JorgeRojo/mueble-aspiradora/docs/README.md

# Documentación Técnica: Proyecto Mueble Consola Cuadrada Dreame a Cota Cero

Documentación técnica integral para la fabricación, despiece, montaje y automatización del mueble recibidor cuadrado a medida ($540 \times 540\text{ mm}$) para la estación robot aspirador **Dreame L10s / X40**.

---

## 1. Documentos Técnicos del Proyecto

1. ### [Guía Maestra y Manual de Construcción (`../README.md`)](../README.md)
   * Visión general del mueble con encimera cuadrada de $54 \times 54\text{ cm}$ y altura de $75\text{ cm}$.
   * Lista de materiales comerciales (BOM) y aprovechamiento de los tableros comprados ($60 \times 120\text{ cm}$).
   * Procedimiento de fabricación paso a paso: despiece, cajeado de rodapié, regrueso perimetral a 25 mm, cazoletas de bisagras y acabado en blanco satinado.

2. ### [Especificaciones Técnicas y Constructivas (`especificaciones_tecnicas.md`)](especificaciones_tecnicas.md)
   * **Justificación dimensional de la planta cuadrada ($540 \times 540\text{ mm}$)** a partir de la rampa de la base Dreame y el rodapié de 15 mm.
   * **Arquitectura a Cota Cero**: Apoyo directo sobre el suelo de la vivienda, sin travesaños inferiores ni trasera.
   * **Interior 100% diáfano**: Sin balda intermedia, dejando 157 mm libres sobre la estación Dreame para la extracción vertical de los depósitos de agua.
   * **Sistema de doble puerta batiente**: Dos hojas de $268 \times 723\text{ mm}$ motorizadas con apertura hacia delante.
   * **Automatización y cableado Zigbee**: Conexión de actuadores en paralelo al relé inteligente MHCOZY de 2 canales con enclavamiento (*Interlock*).

3. ### [Planos Técnicos y Esquemas de Cotas (`planos_cotas.md`)](planos_cotas.md)
   * Esquema de cotas en alzado frontal con ambas puertas abiertas.
   * Esquema en planta superior con corte de profundidad, cajeado para rodapié ($18 \times 95\text{ mm}$) y holgura frontal de seguridad ($14\text{ mm}$).
   * Tabla completa de tolerancias y holguras críticas de funcionamiento.

---

## 2. Renders y Planos Fotorrealistas de Referencia

* **Plano Fotorrealista con Cotas Milimétricas**: [`../foto_realista_mueble_cuadrado_cotas.jpg`](../foto_realista_mueble_cuadrado_cotas.jpg)
  * Muestra el mueble acotado milimétricamente ($540 \times 540\text{ mm}$ encimera, $750\text{ mm}$ alto, $268\text{ mm}$ puertas, $490\text{ mm}$ interior, $423\text{ mm}$ base, $157\text{ mm}$ espacio libre superior y actuadores 12V con carrera de 150 mm).
* **Fotografía Realista Principal (Doble Puerta Abierta)**: [`../foto_realista_mueble_cuadrado_dos_puertas.jpg`](../foto_realista_mueble_cuadrado_dos_puertas.jpg)
  * Muestra la consola cuadrada lacada en blanco satinado, las dos puertas abiertas hacia delante a cota cero, la estación Dreame interior y el robot saliendo por el centro sobre el parqué de espiga.
