JorgeRojo/mueble-aspiradora/foto_realista_mueble_cuadrado_cotas.jpg

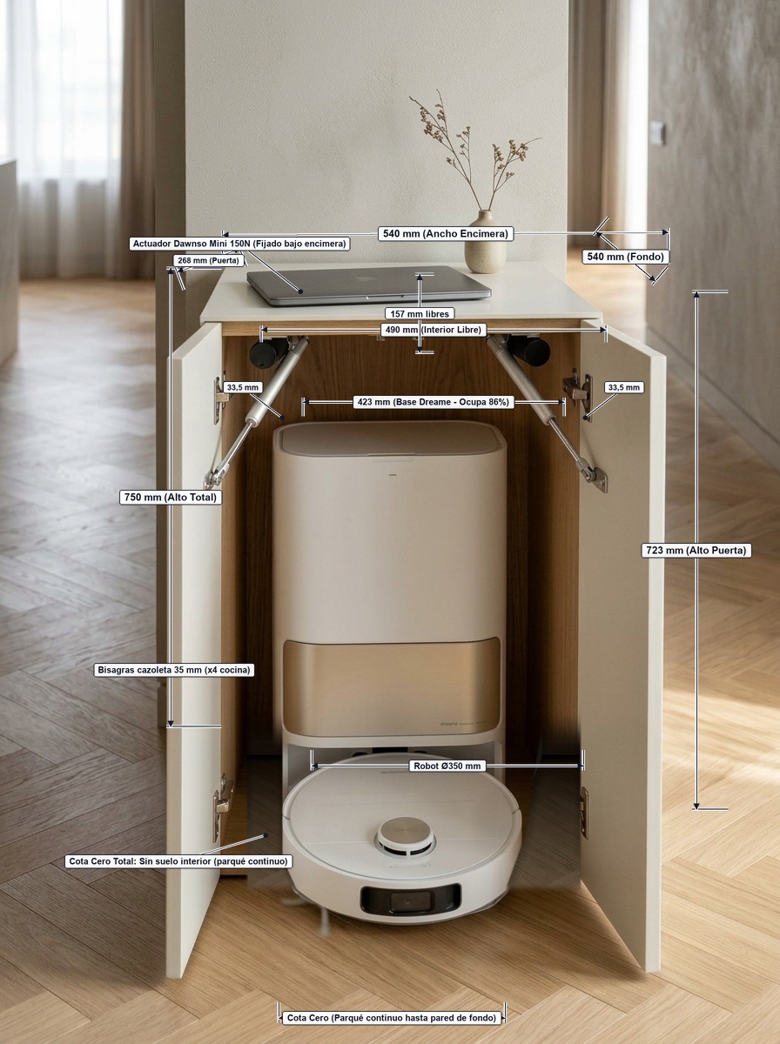
foto_realista_mueble_cuadrado_cotas.jpg
