JorgeRojo/mueble-aspiradora/planos/Vista_3D_Mecanismo_Abierto_Detalle.png

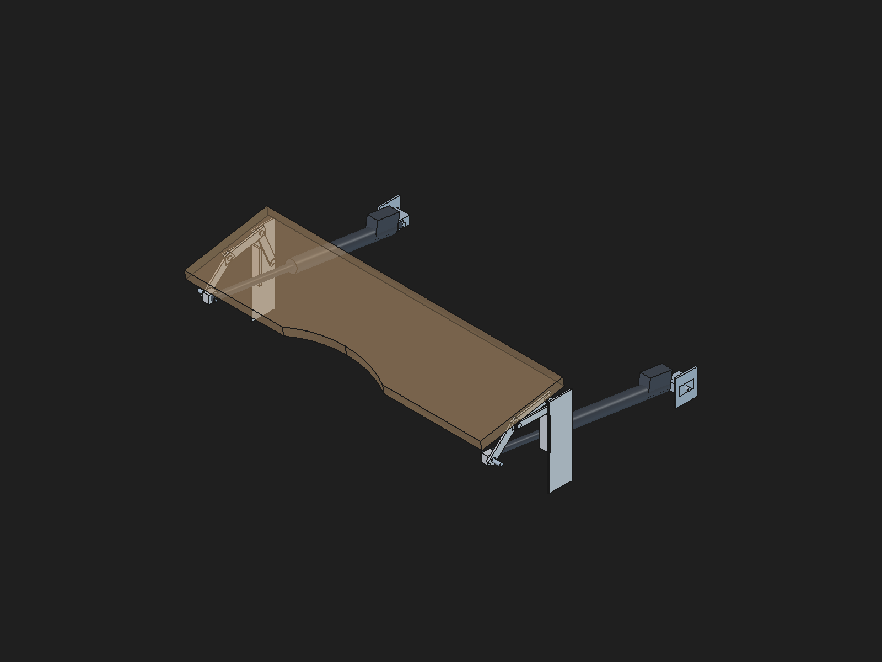
planos/Vista_3D_Mecanismo_Abierto_Detalle.png
