JorgeRojo/mueble-aspiradora/planos/Vista_3D_Perfil_Mecanismo_Abierto.png

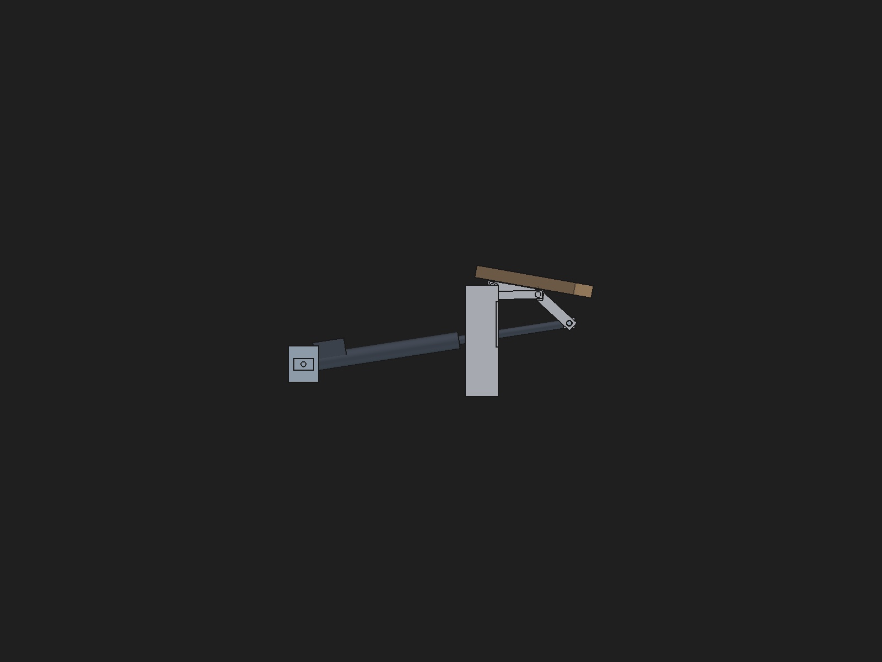
planos/Vista_3D_Perfil_Mecanismo_Abierto.png
