JorgeRojo/mueble-aspiradora/planos/Vista_3D_Trasera_Nervio_Superior.png

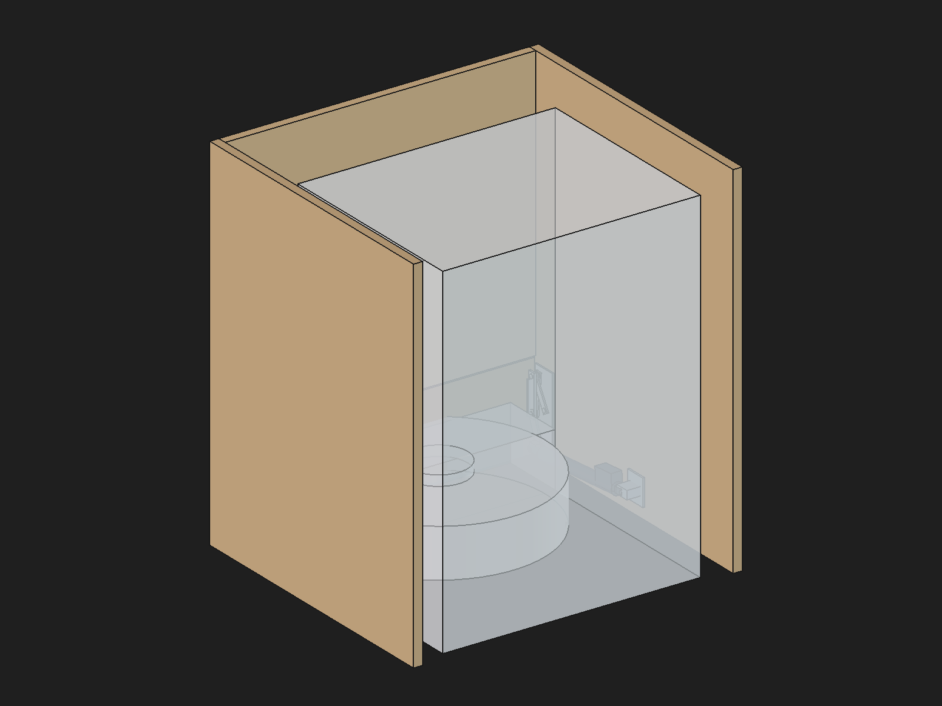
planos/Vista_3D_Trasera_Nervio_Superior.png
