JorgeRojo/mueble-aspiradora/Mueble_Aspiradora_Cota_Cero.FCStd

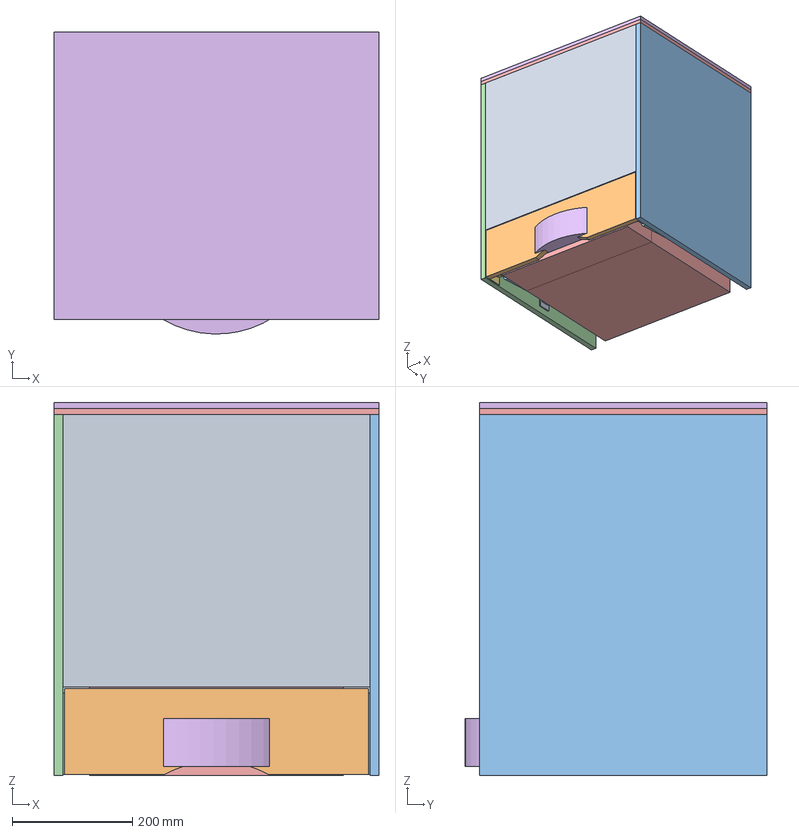
[picture p10: CAD file, 2026-11-04]
Mueble_Aspiradora_Cota_Cero.FCStd
540.0 x 501.9 x 620.0 mm
[P03] Cubierta Frontal Fija (510x453x15mm)
[P04] Porton Abatible 80deg (506x143x15mm)
[P02] Costado Derecho (478x600x15mm)
[P01] Costado Izquierdo (478x600x15mm)
Estacion Dreame (423x480x568mm)
Robot Dreame (Ø350x97mm)
[H01] Bisagra Garosa 80deg SIN Muelle Izq
[H01] Bisagra Garosa 80deg SIN Muelle Der
[H03] Soportes Actuador Lineal Izq
[H03] Soportes Actuador Lineal Der
[H02] Actuador Lineal Dawnso 215/325mm Izq
[H02] Actuador Lineal Dawnso 215/325mm Der
[P06] Lamina Superior Base (540x478x10mm)
[P07] Lamina Superior Tapa (540x478x10mm)
[P05] Nervio Trasero Superior (510x35x15mm)
