JorgeRojo/mueble-aspiradora/planos/Mecanismo_Metalico_Bisagras_y_Actuadores.step

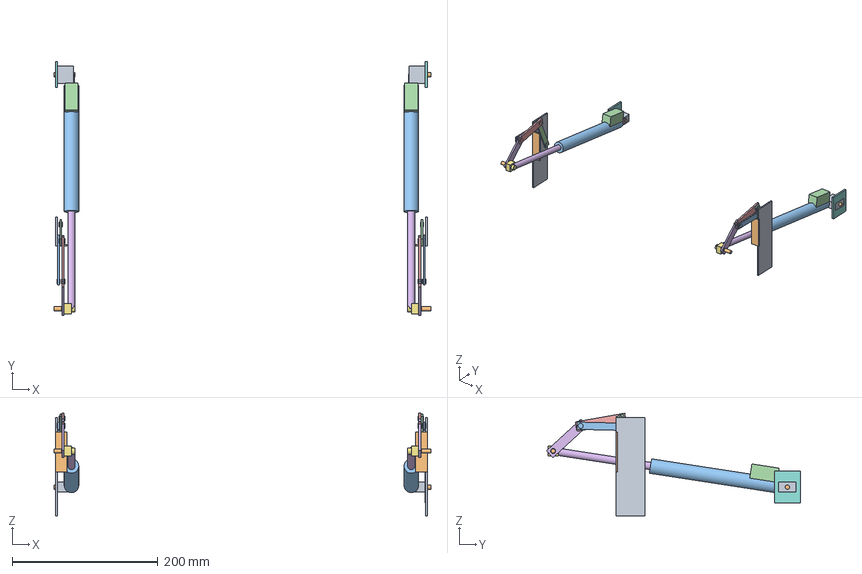
[picture p11: CAD file, 2026-11-01]
planos/Mecanismo_Metalico_Bisagras_y_Actuadores.step
517.0 x 348.4 x 140.7 mm
