JorgeRojo/mueble-aspiradora/(list of files, cad)

Other CAD files:
Mecanismo_Metalico_Bisagras_y_Actuadores.FCStd
Modulo_01_Porton_Abierto_80deg.FCStd
