JorgeRojo/mueble-aspiradora/planos/Planos_Corte_Madera_Diseño_Final_A4.pdf

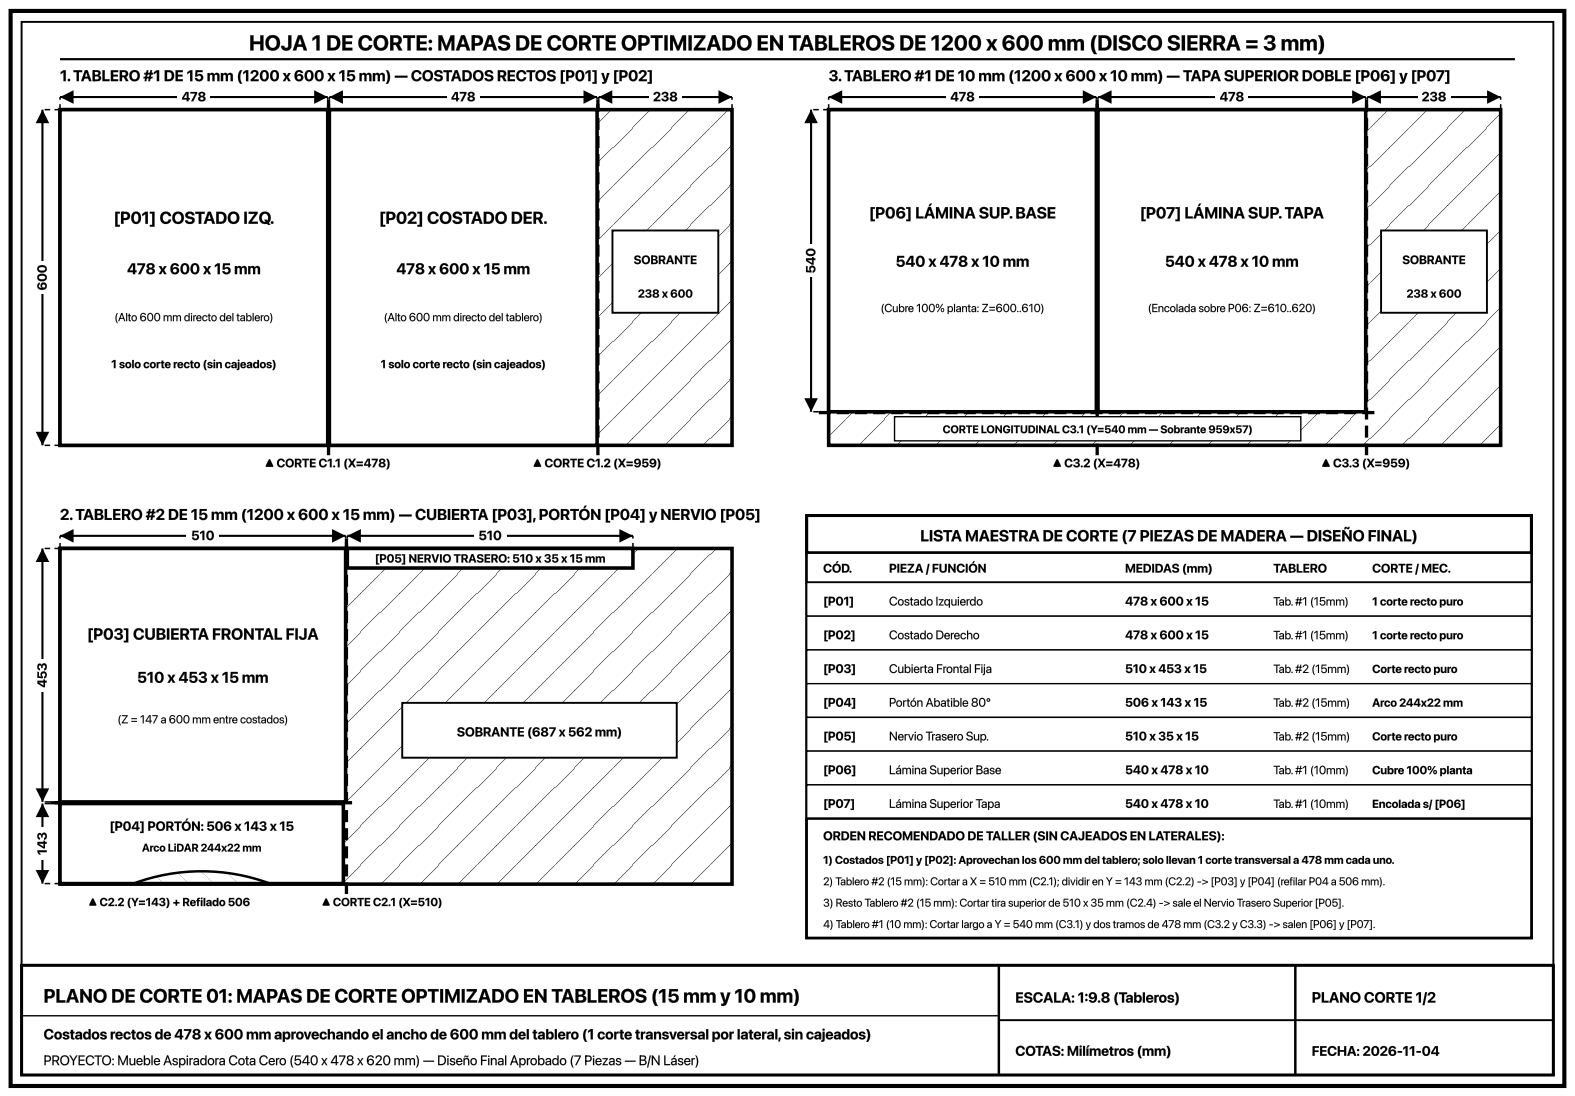
[picture p13: page 1]

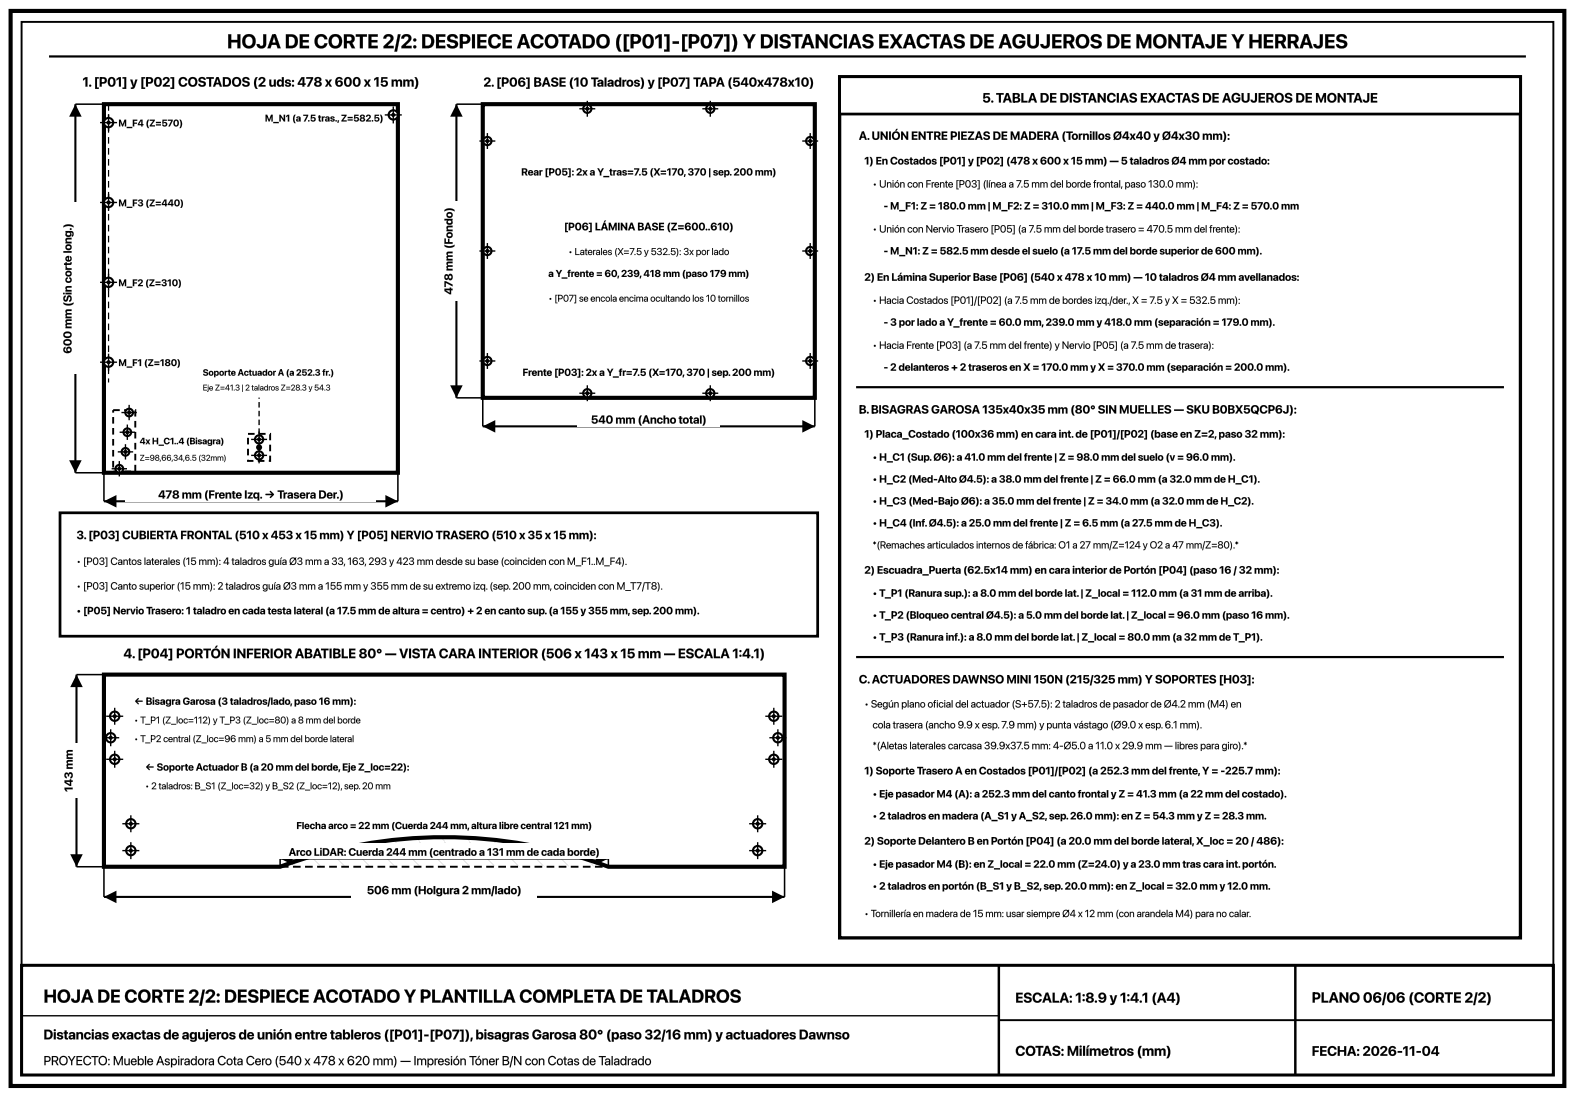
[picture p14: page 2]
