JorgeRojo/mueble-aspiradora/ssss.pdf

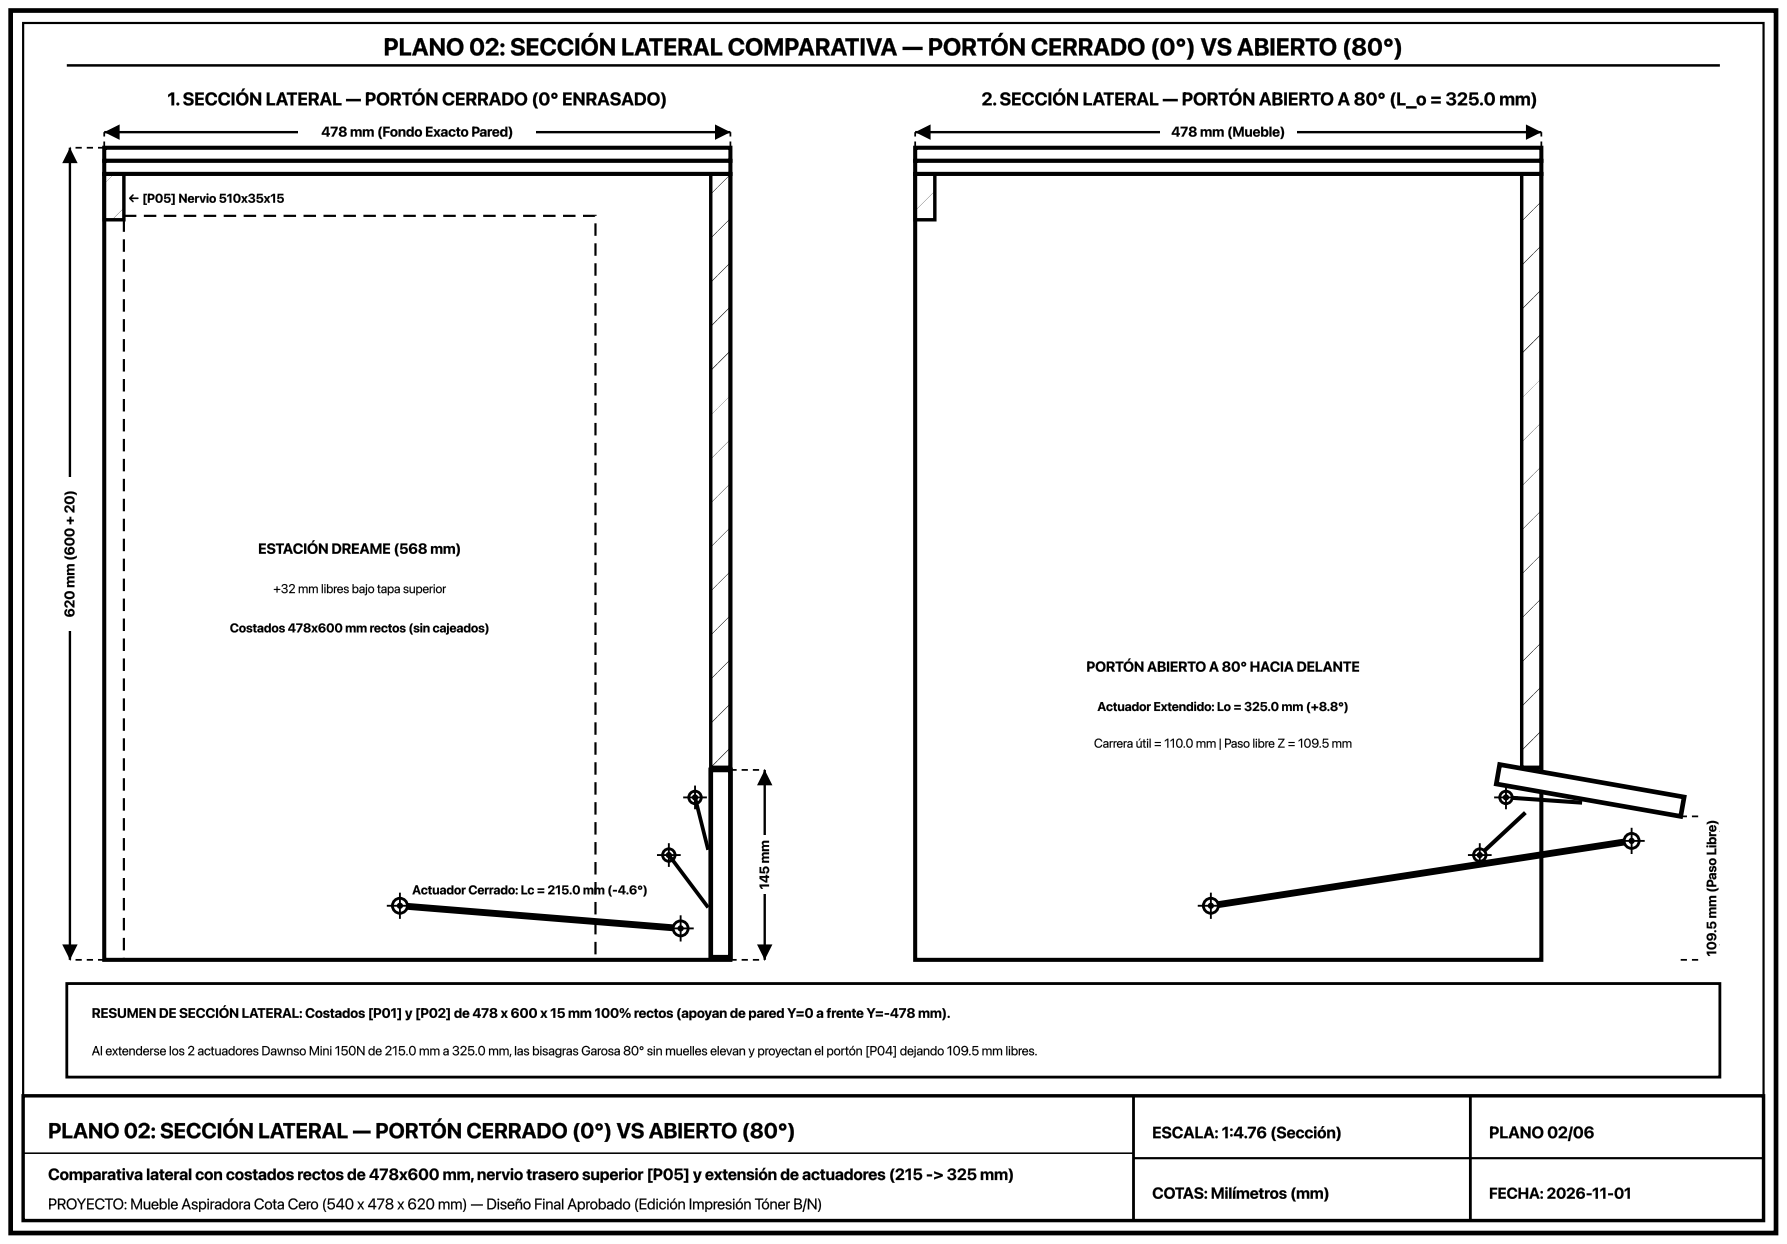
[picture p15: page 1]
