JorgeRojo/mueble-aspiradora/planos/Plano_01_Alzado_y_Planta_A4.pdf

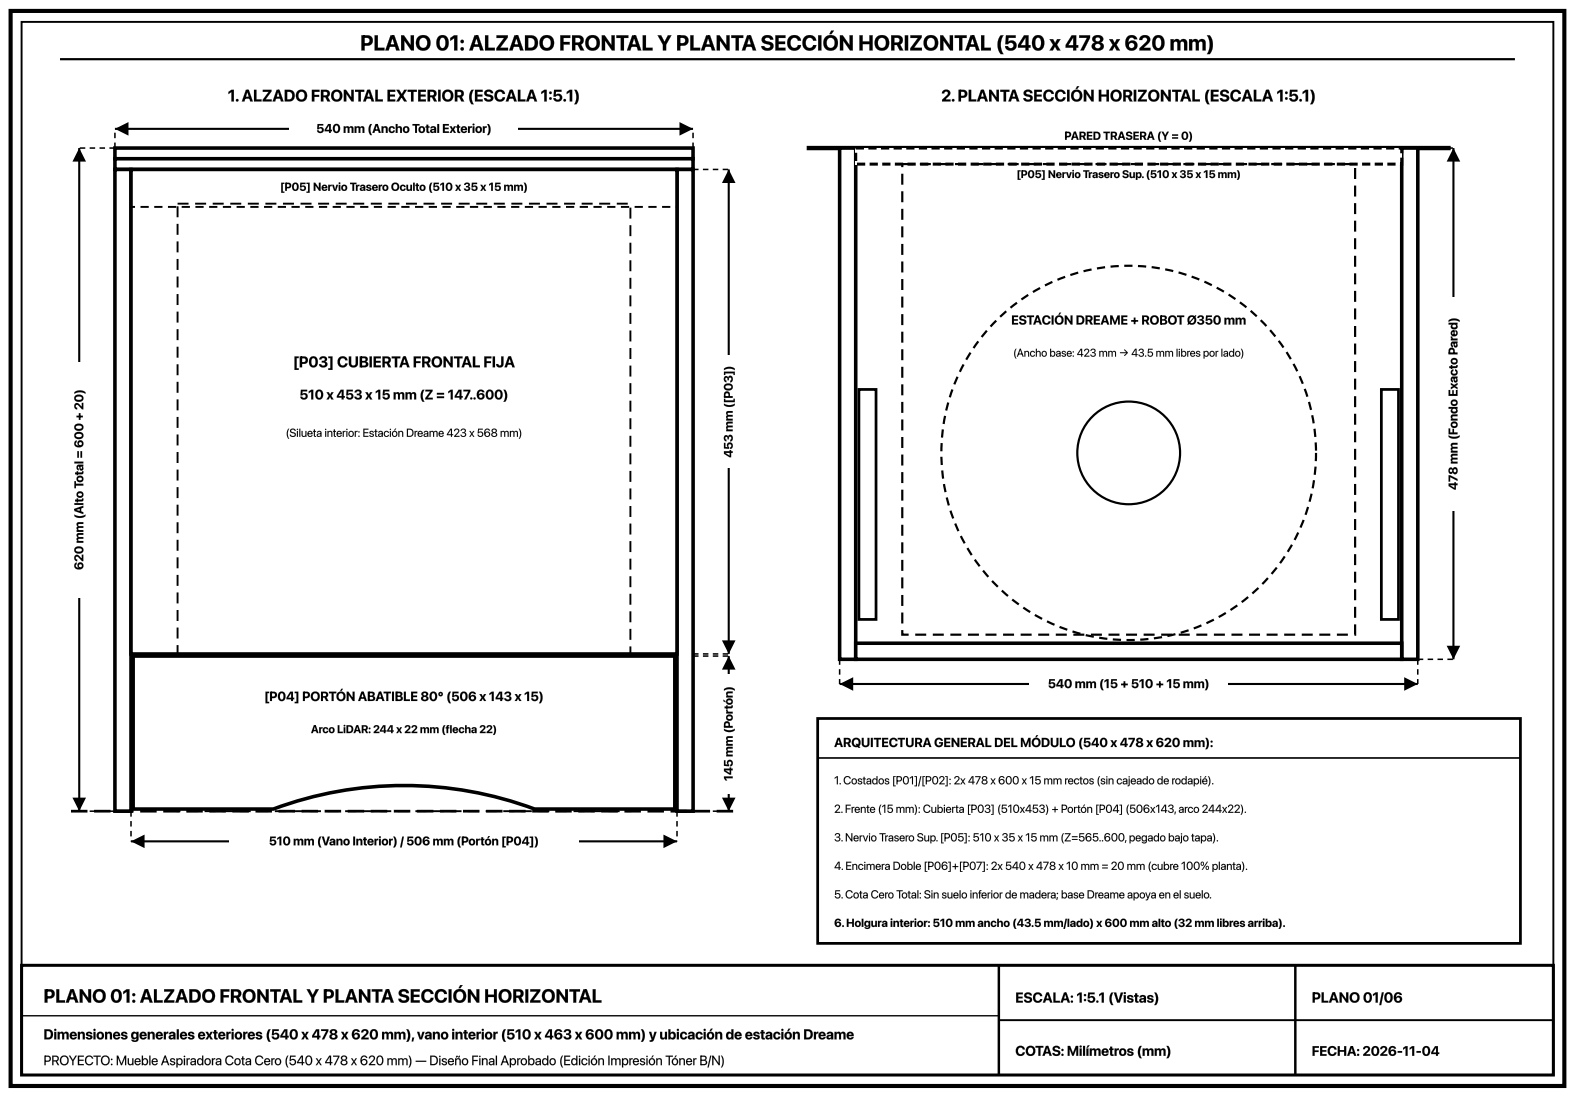
[picture p16: page 1]
