JorgeRojo/mueble-aspiradora/planos/Plano_02_Perfil_e_Isometrica_A4.pdf

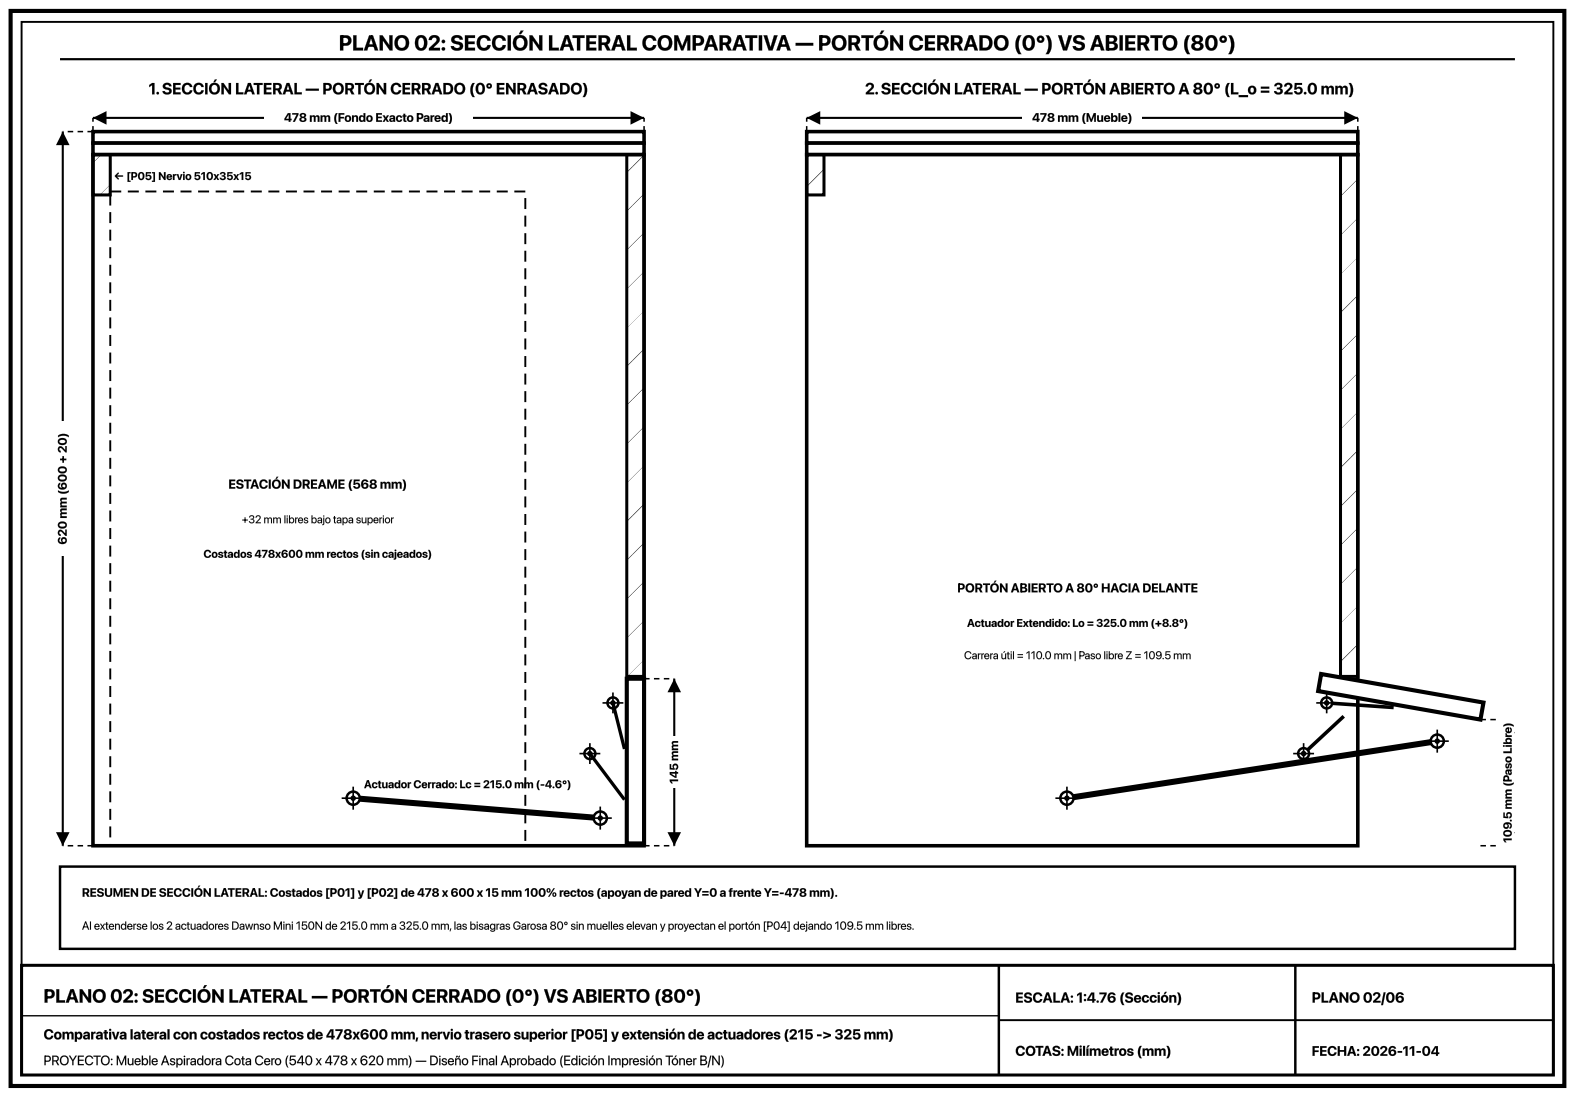
[picture p17: page 1]
