JorgeRojo/mueble-aspiradora/planos/Plano_03_Despiece_Carpinteria_A4.pdf

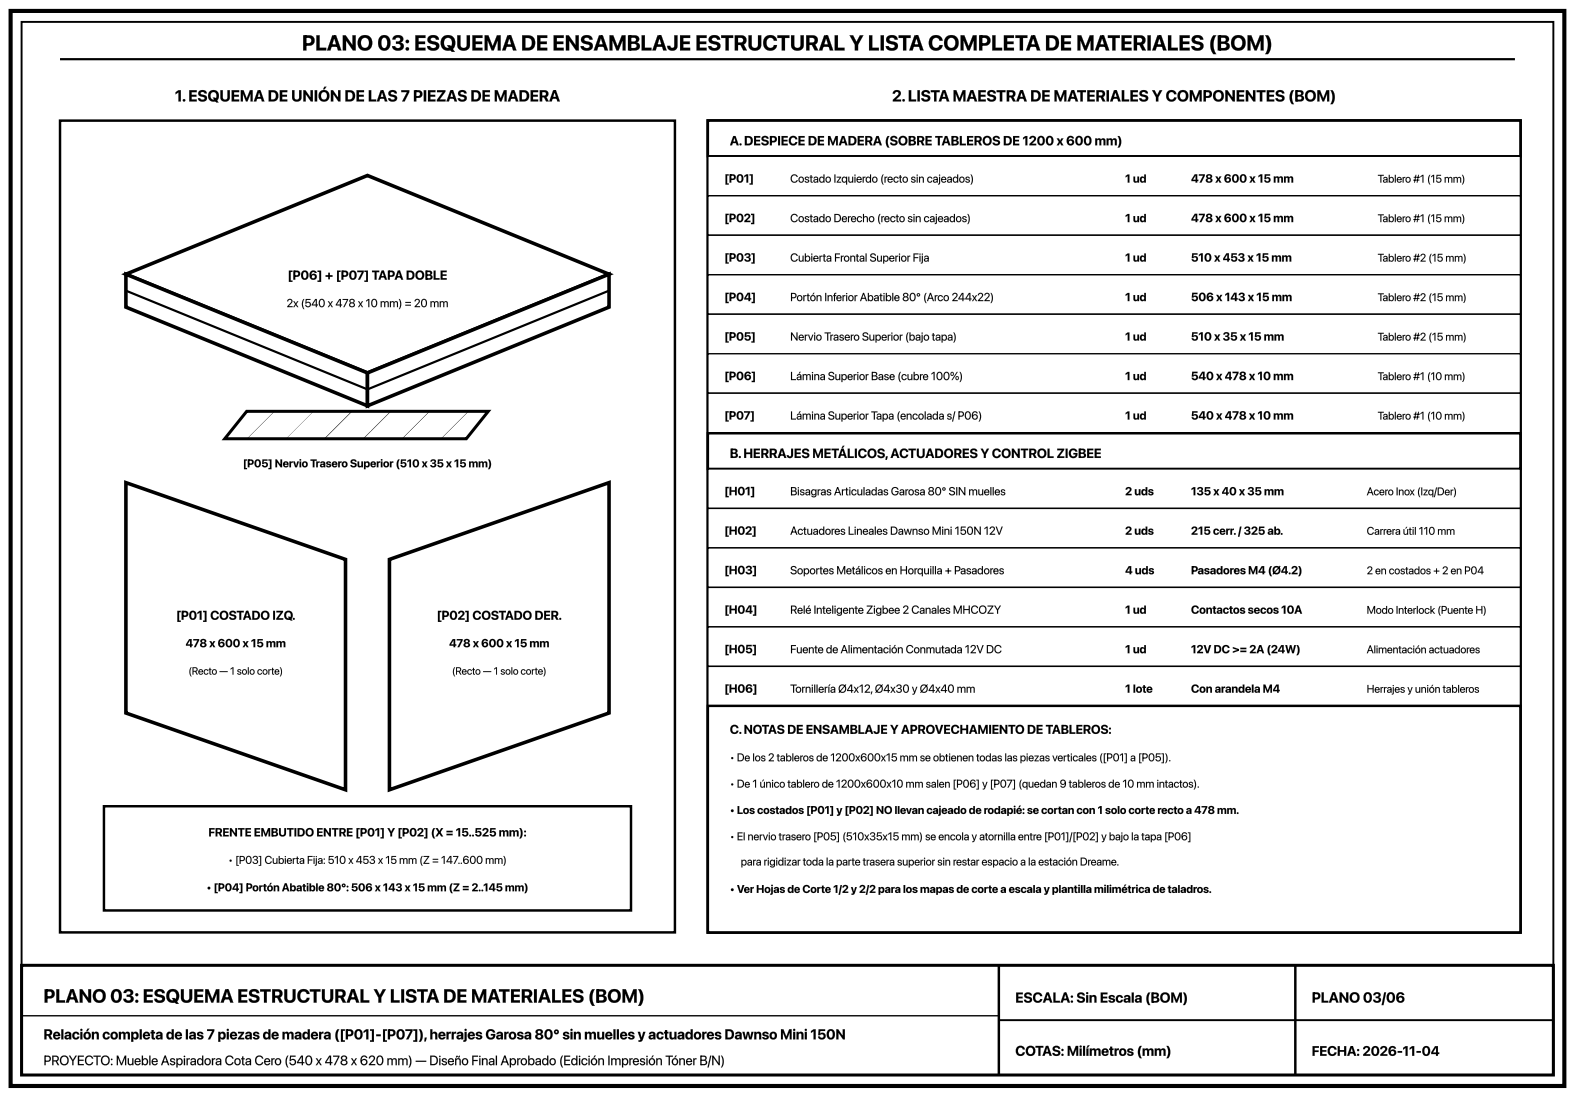
[picture p18: page 1]
