JorgeRojo/mueble-aspiradora/planos/Plano_04_Cinematica_Bisagras_80deg_y_Actuadores_A4.pdf

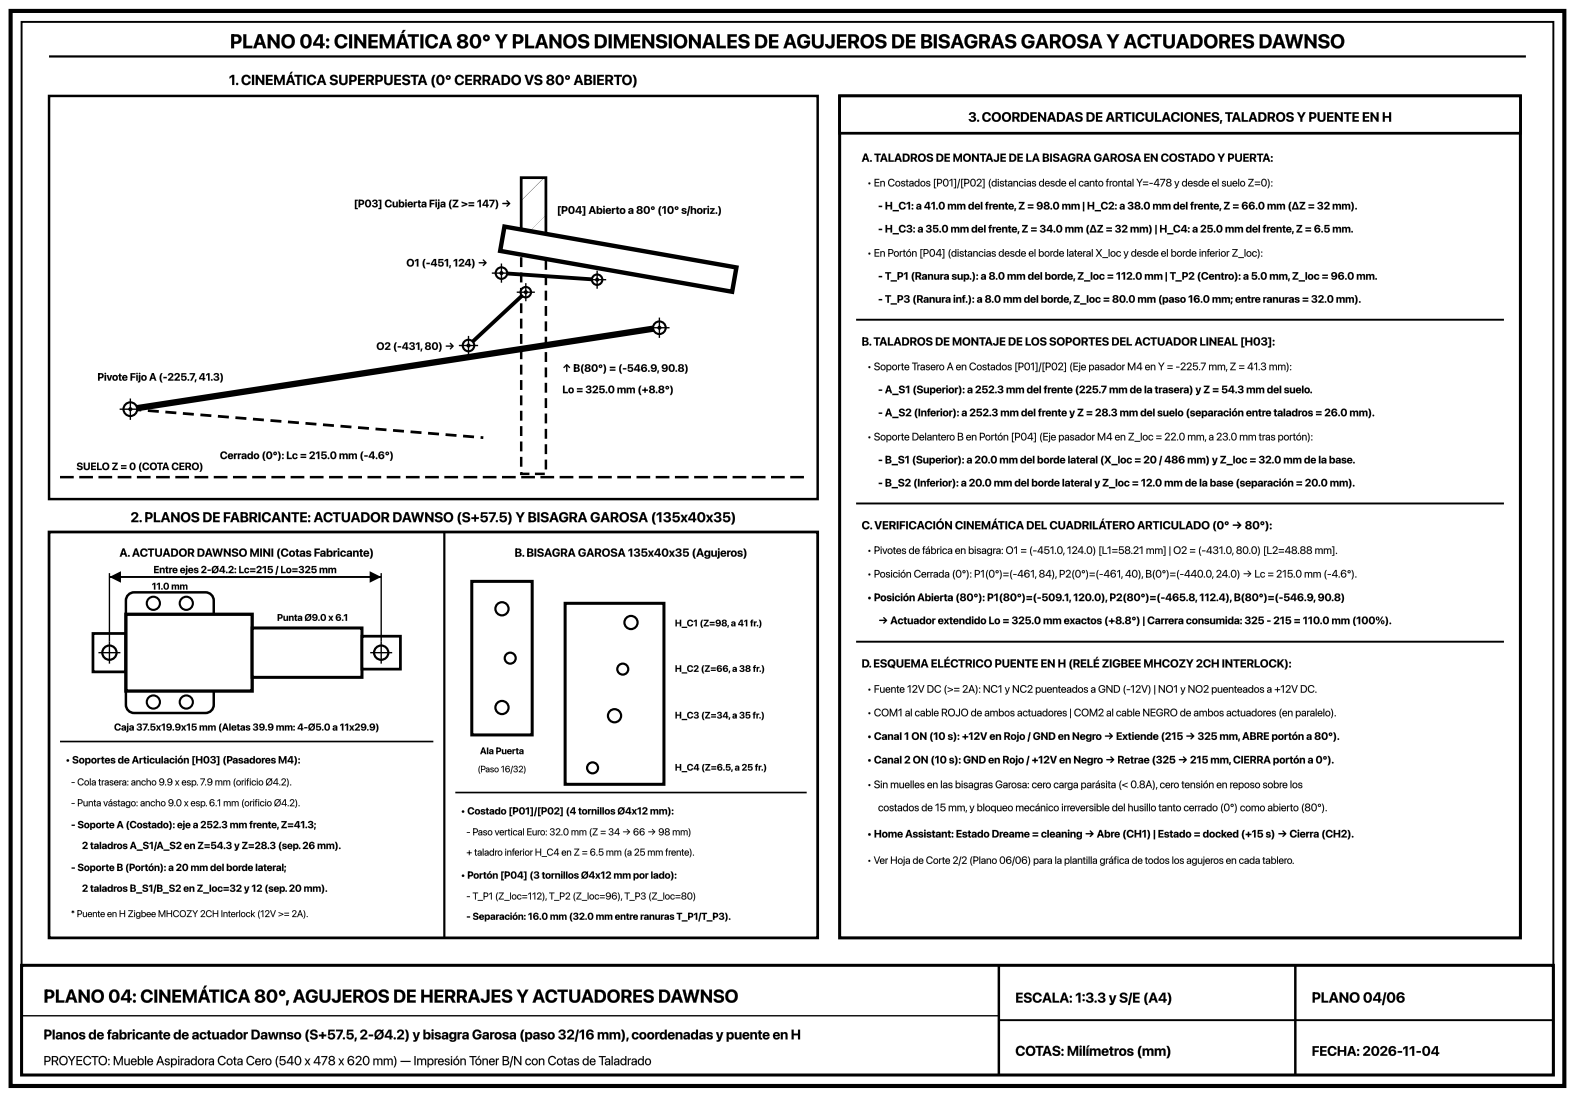
[picture p19: page 1]
