JorgeRojo/mueble-aspiradora/planos/Plano_04_Puerta_Vertical_y_Actuadores_A4.pdf

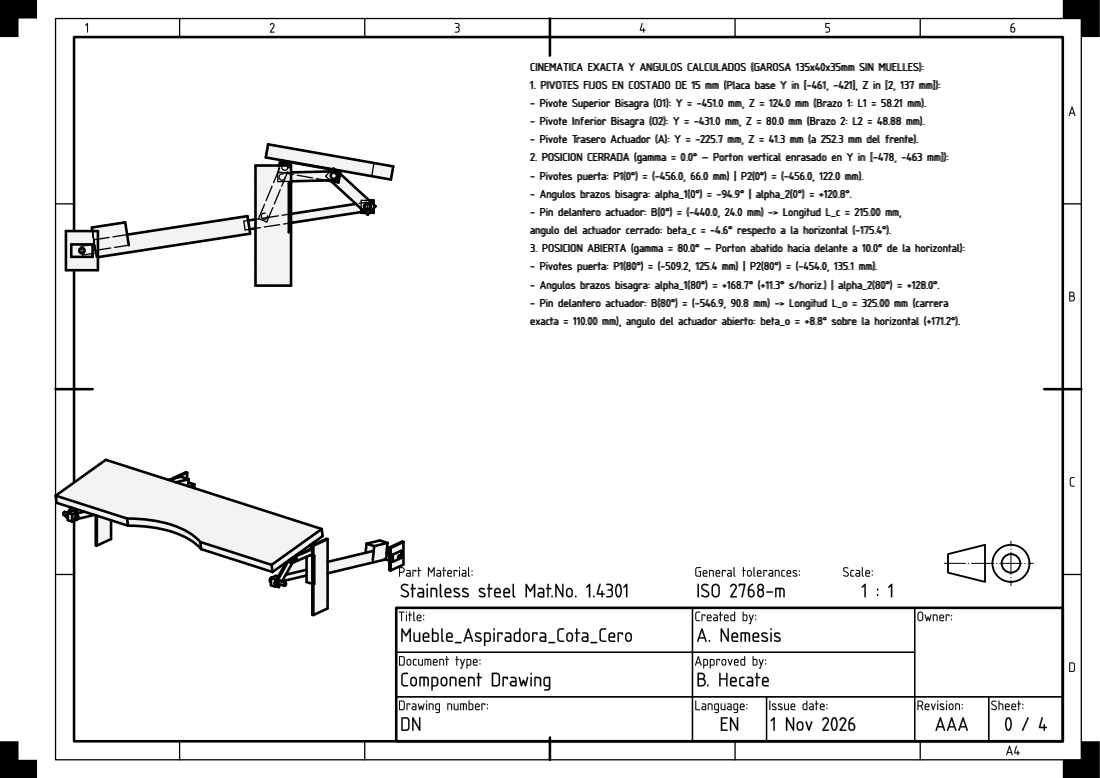
[picture p20: page 1]

CINEMATICA EXACTA Y ANGULOS CALCULADOS (GAROSA 135x40x35mm SIN MUELLES):
1. PIVOTES FIJOS EN COSTADO DE 15 mm (Placa base Y in [-461, -421], Z in [2, 137 mm]):
-- PPiivvoottee SSuuppeerriioorr BBiissaaggrraa ((OO11)):: YY == --445511..00 mmmm,, ZZ == 112244..00 mmmm ((BBrraazzoo 11:: LL11 == 5588..2211 mmmm))..
-- PPiivvoottee IInnffeerriioorr BBiissaaggrraa ((OO22)):: YY == --443311..00 mmmm,, ZZ == 8800..00 mmmm ((BBrraazzoo 22:: LL22 == 4488..8888 mmmm))..
-- PPiivvoottee TTrraasseerroo AAccttuuaaddoorr ((AA)):: YY == --222255..77 mmmm,, ZZ == 4411..33 mmmm ((aa 225522..33 mmmm ddeell ffrreennttee))..
2. POSICION CERRADA (gamma = 0.0° — Porton vertical enrasado en Y in [-478, -463 mm]):
-- PPiivvootteess ppuueerrttaa:: PP11((00°°)) == ((--445566..00,, 6666..00 mmmm)) || PP22((00°°)) == ((--445566..00,, 112222..00 mmmm))..
- Angulos brazos bisagra: alpha_1(0°) = -94.9° | alpha_2(0°) = +120.8°.
-- PPiinn ddeellaanntteerroo aaccttuuaaddoorr:: BB((00°°)) == ((--444400..00,, 2244..00 mmmm)) -->> LLoonnggiittuudd LL__cc == 221155..0000 mmmm,,
angulo del actuador cerrado: beta_c = -4.6° respecto a la horizontal (-175.4°).
3. POSICION ABIERTA (gamma = 80.0° — Porton abatido hacia delante a 10.0° de la horizontal):
-- PPiivvootteess ppuueerrttaa:: PP11((8800°°)) == ((--550099..22,, 112255..44 mmmm)) || PP22((8800°°)) == ((--445544..00,, 113355..11 mmmm))..
- Angulos brazos bisagra: alpha_1(80°) = +168.7° (+11.3° s/horiz.) | alpha_2(80°) = +128.0°.
-- PPiinn ddeellaanntteerroo aaccttuuaaddoorr:: BB((8800°°)) == ((--554466..99,, 9900..88 mmmm)) -->> LLoonnggiittuudd LL__oo == 332255..0000 mmmm ((ccaarrrreerraa
exacta = 110.00 mm), angulo del actuador abierto: beta_o = +8.8° sobre la horizontal (+171.2°).
