JorgeRojo/mueble-aspiradora/(commit log)

2026-10-04 docs: actualizar documentacion con nuevos materiales contrachapado 10+15mm, actuador 150N, rele Zigbee 2CH y renders realistas
2026-10-04 refactor: limpiar artefactos obsoletos y consolidar guia maestra de construccion con planos limpios y componentes comprados
2026-10-04 feat: agregar fotografia arquitectonica realista con puerta abierta mostrando mecanismo de guillotina y cota cero
2026-10-04 docs: armonizar y corregir cotas de despiece de costados (522mm), esquema de planta y docs/README.md
2026-10-04 feat: correccion cinematica de actuadores en diagonal 3D, calculo con Teorema del Coseno, 4 bisagras cocina 35mm y renders actualizados
2026-10-04 feat: actuadores Dawnso Mini 150N bajo encimera, cota cero sin suelo de madera, 4 bisagras y plano acotado final
2026-10-04 feat: proporciones de ancho y esbeltez 1.39:1 exactas (54x54x75cm), base ocupando el 86% y cotas milimetricas vectoriales
2026-10-04 feat: eliminacion total de suelo interior, cota cero real con parque continuo y plano acotado
2026-11-01 feat: diseño final 540x478x620mm con porton 80 deg, modelos 3D FreeCAD y planos de corte A4
2026-11-01 chore: eliminar imagenes y documentacion de diseños antiguos dejando exclusivamente el diseño final
2026-11-01 feat: regenerar los 6 planos A4 en blanco y negro puro para impresora laser de toner negro
2026-11-01 feat: añadir distancias exactas de todos los agujeros de montaje de madera, bisagras Garosa y actuadores Dawnso
2026-11-01 chore: eliminar objetos y renders obsoletos de iteraciones previas y actualizar vista 3D cerrada final
2026-11-04 fix: ajustar márgenes de impresión A4 (24mm H / 18.8mm V), limpiar objetos/archivos de iteraciones previas y actualizar documentación
2026-11-04 chore: eliminar archivo de prueba ssss.pdf
